z00m128/speccy2010/documentation/speccy2010_r1_bottom.jpg

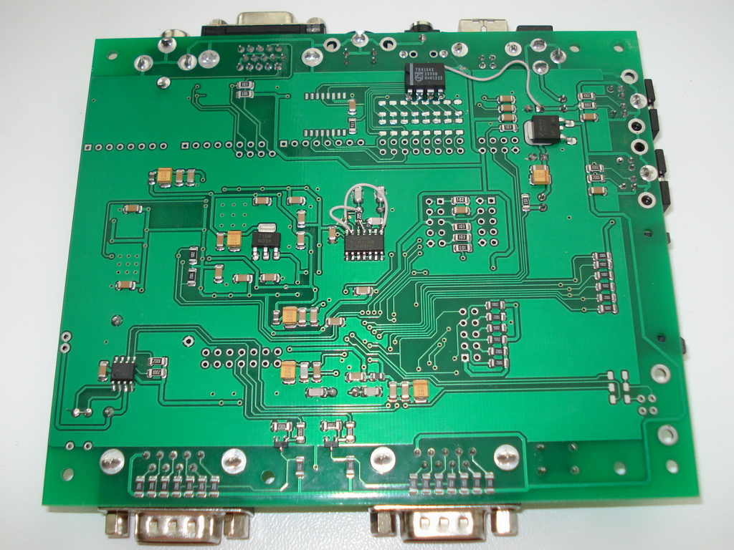
documentation/speccy2010_r1_bottom.jpg
