z00m128/speccy2010/documentation/speccy2010_r1_top.jpg

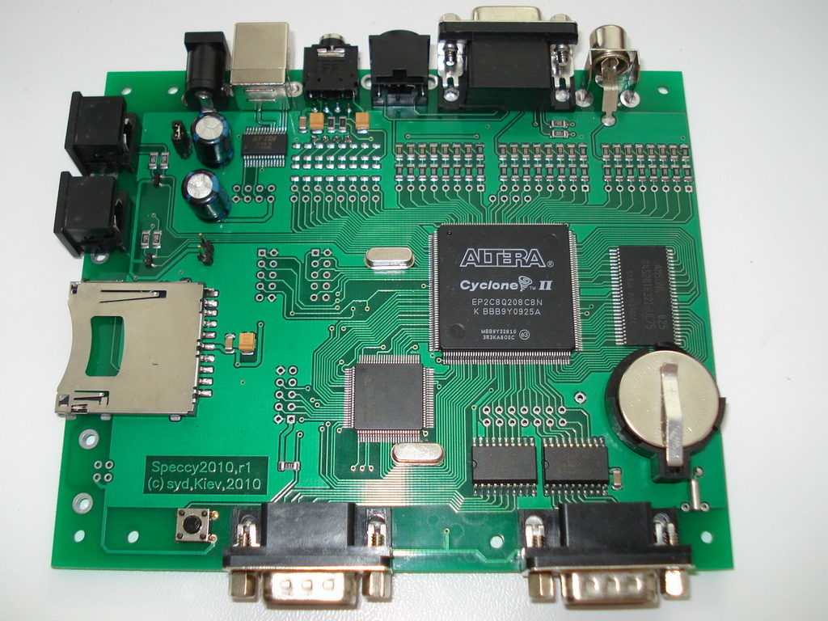
documentation/speccy2010_r1_top.jpg
