z00m128/speccy2010/documentation/Speccy2010-sticker.pdf

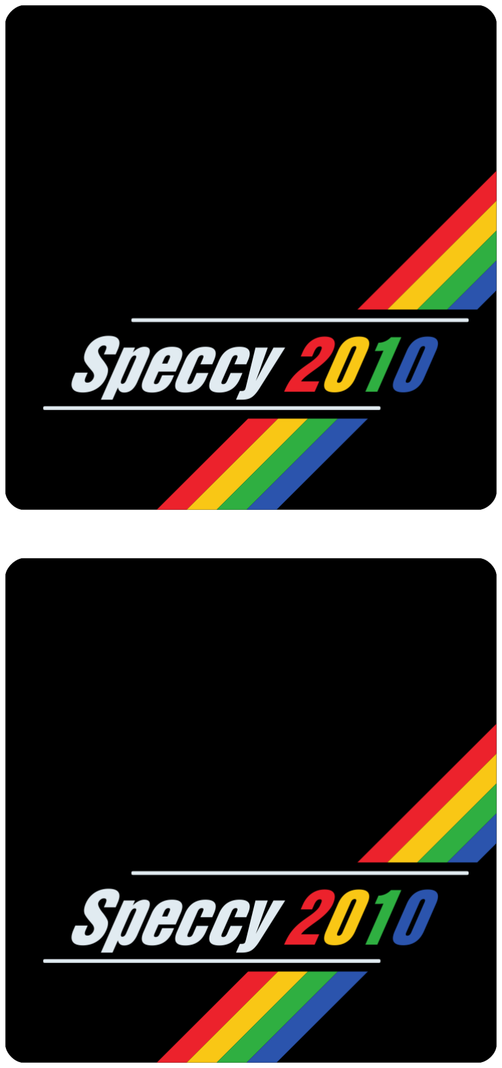
[picture p3: page 1]
