z00m128/speccy2010/documentation/codeblocks.png

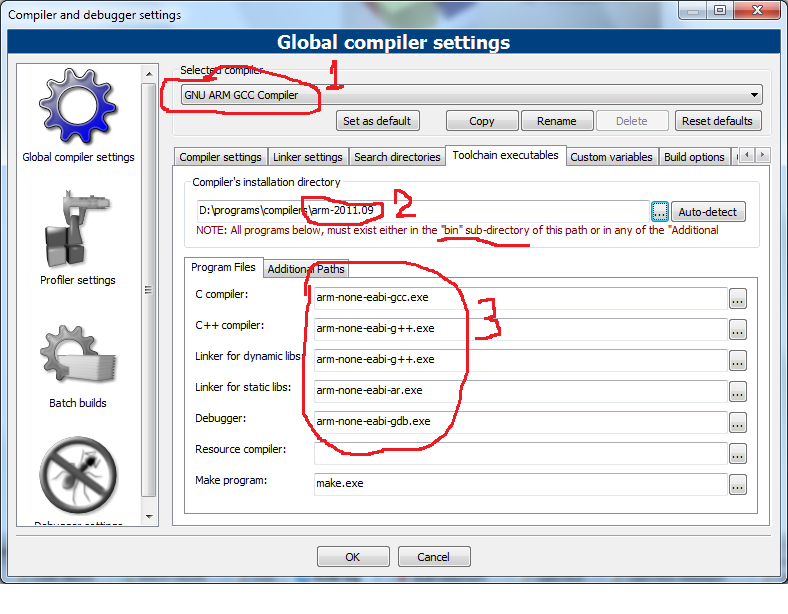
documentation/codeblocks.png
