z00m128/speccy2010/documentation/Speccy2010-sticker.png

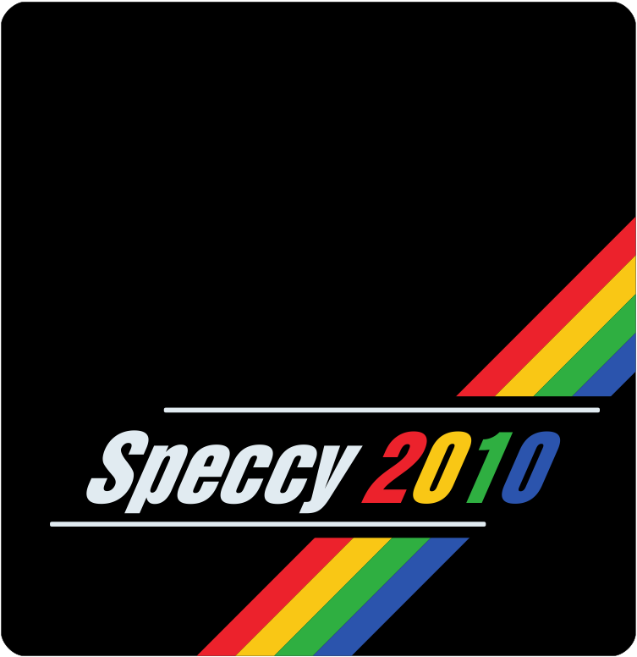
documentation/Speccy2010-sticker.png
