z00m128/speccy2010/documentation/Speccy2010_r2.bom.pdf

Перечень комплектующих

Резистор | R1206 0.25W, 100 1% | 21 | R42, R44, R46, R48, R50, R52, R54, R56, R58, R60, R62, R64, R66, R68, R70, R72, R74, R76, R80, R82, R84
Резистор | R1206 0.25W, 150 | 6 | R3, R6, R16, R17, R90, R95
Резистор | R1206 0.25W, 200 1% | 27 | R38, R39, R40, R41, R43, R45, R47, R49, R51, R53, R55, R57, R59, R61, R63, R65, R67, R69, R71, R73, R75, R79, R81, R83, R85, R86, R87
Резистор | R1206 0.25W, 750 1% | 2 | R104, R110
Резистор | R1206 0.25W, 887 1% | 1 | R109
Резистор | R1206 0.25W, 1k | 1 | R130
Резистор | R1206 0.25W, 2k | 10 | R1, R2, R14, R15, R22, R26, R29, R33, R141, R142
Резистор | R1206 0.25W, 10k | 36 | R8, R9, R10, R11, R12, R13, R18, R19, R21, R23, R24, R25, R27, R30, R31, R32, R34, R35, R36, R37, R77, R78, R125, R126, R127, R128, R129, R131, R132, R133, R134, R135, R136, R137, R138, R139
Резистор | R1206 0.25W, 2M | 1 | R140
Конденсатор | C1206-X7R-50V, 22p | 2 | C23, C24
Конденсатор | C1206-X7R-50V, 33p | 2 | C36, C40
Конденсатор | C1206-X7R-50V, 47p | 1 | C39
Конденсатор | C1206-X7R-50V, 1n | 3 | C43, C46, C49
Конденсатор | C1206-X7R-50V, 33n | 1 | C26
Конденсатор | C1206-X7R-50V, 100n | 27 | C1, C2, C4, C5, C6, C9, C10, C11, C12, C13, C14, C15, C16, C17, C18, C19, C21, C28, C29, C30, C31, C32, C33, C42, C45, C48, C50
Конденсатор | C1206-X7R-50V, 1u | 1 | C27
Конденсатор | EHR-220.0X25V, 220.0-25V | 2 | C34, C35
Конденсатор | TAJB106M016R, 10.0-16V | 9 | C3, C7, C8, C25, C37, C38, C41, C44, C47
Катушка индуктивности | BLM21AG601SN1 | 3 | L1, L2, L3
Кварц | HC3X8, 32.768 | 1 | BQ3
Кварц | HC49U, 20MHz | 1 | BQ2
Кварц | HC49U, 4MHz | 1 | BQ1
Диод | BAT54C | 2 | VD1, VD2
Транзистор | BC817-40 | 2 | VT1, VT2
Микросхема | LM1117DX-3.3 | 1 | DA1
Микросхема | LM1117MP-ADJ | 1 | DA2
Микросхема | 74HCU04D | 1 | DD8
Микросхема | 74LVC245D | 2 | DD2, DD3
Микросхема | DS1338Z-33+ | 1 | DD9
Микросхема | EP2C8Q208-C8 | 1 | DD5
Микросхема | FT232RL | 1 | DD1
Микросхема | K4S281632-TC75 (K4S561632-TC75) | 1 | DD7
Микросхема | STR755FV2 (STR750FV2) | 1 | DD6
Микросхема | TDA1543 | 1 | DD4`
Разъем | BH1060 | 1 | GB1`
Разъем | DRB-9M | 2 | XP2, XP3
Разъем | PLS-2 | 2 | XP7, XP10
Разъем | DD15RF | 1 | XS9
Разъем | JC-128 | 1 | XS6

Перечень комплектующих

Разъем | MINI-DIN4+3 | 1 | XS8
Разъем | MINI-DIN6+3 | 2 | XS2, XS5
Разъем | POWER | 1 | XS10
Разъем | RCA | 1 | XS7
Разъем | SDC09W4 (104C-TAA0-R) | 1 | XS4
Разъем | USBB-4G | 1 | XS1
Клавиша | KEY | 1 | SB1
Плата печатная | Speccy2010_r2 | 1
Корпус | Z28 | 1
Монтаж | | 1
| | 189
