z00m128/speccy2010/documentation/speccy2010_r2.pcb.pdf

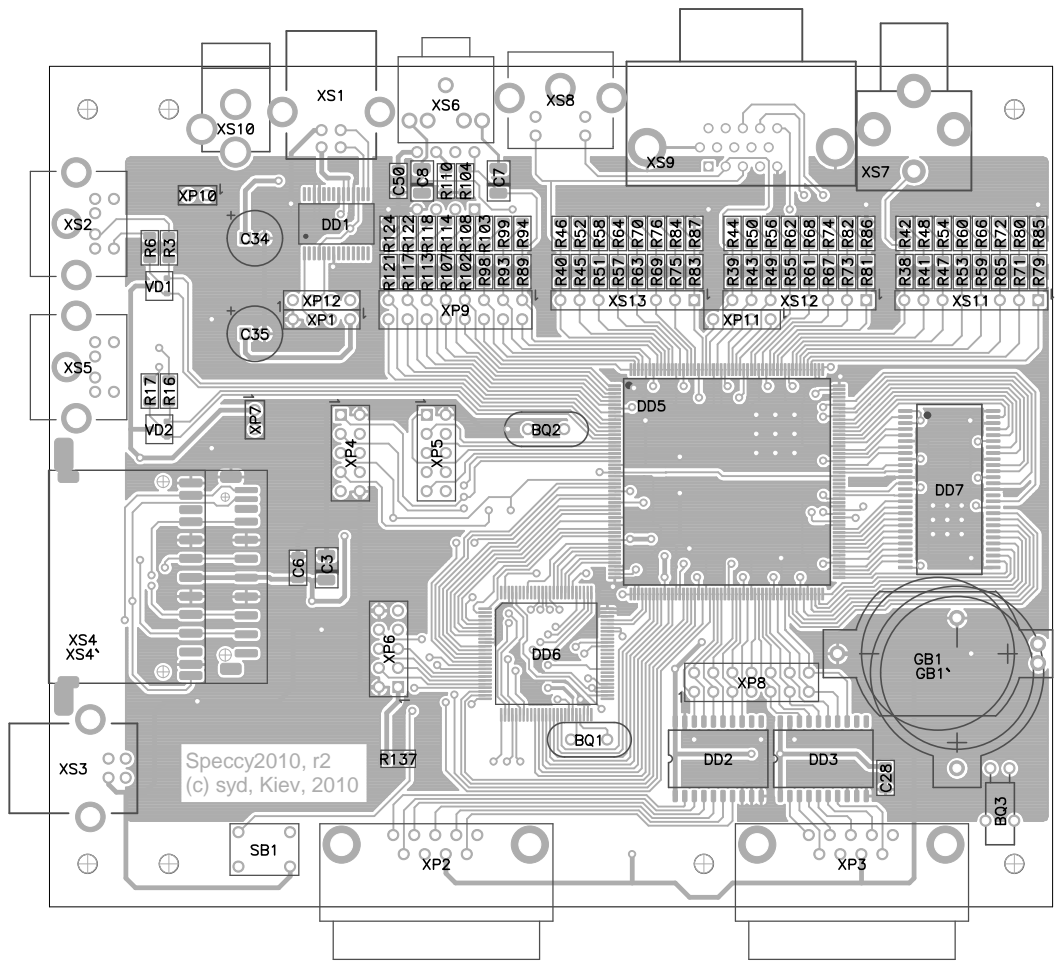
[picture p15: page 1]
Speccy2010, r2 (c) syd, Kiev, 2010

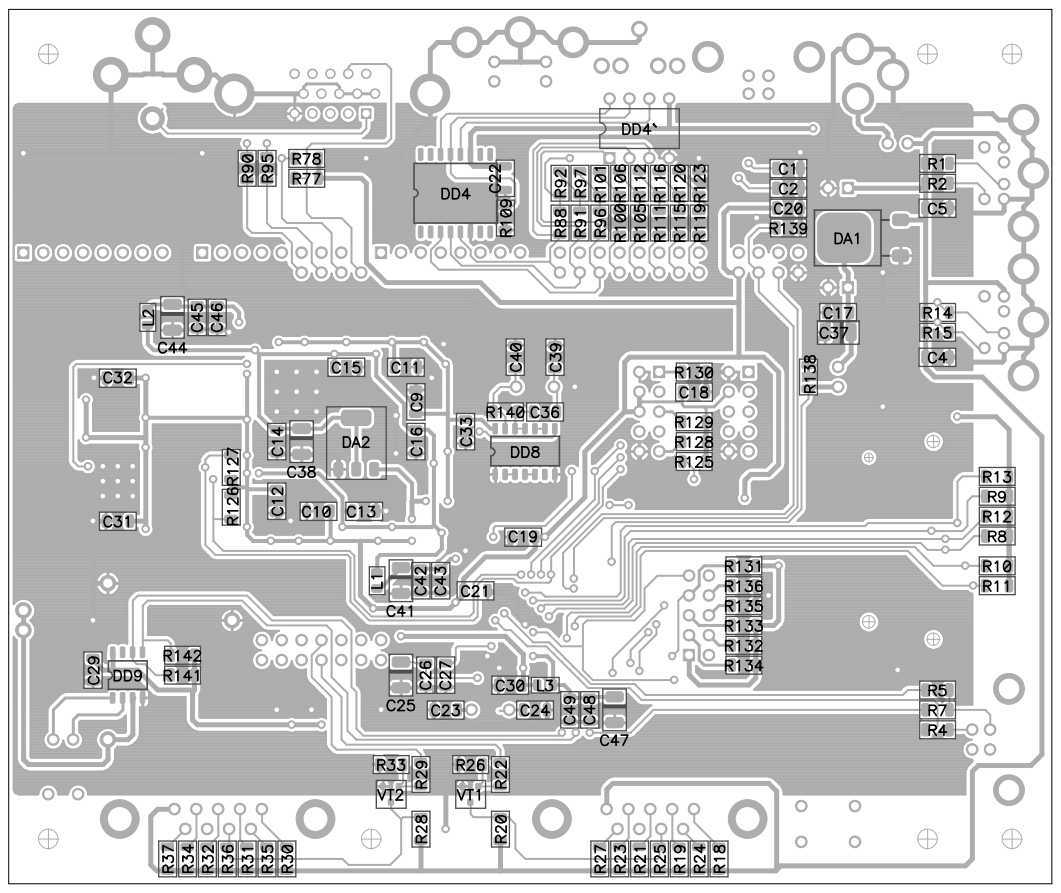
[picture p16: page 2]
