z00m128/speccy2010/documentation/speccy2010_r2.sch.pdf

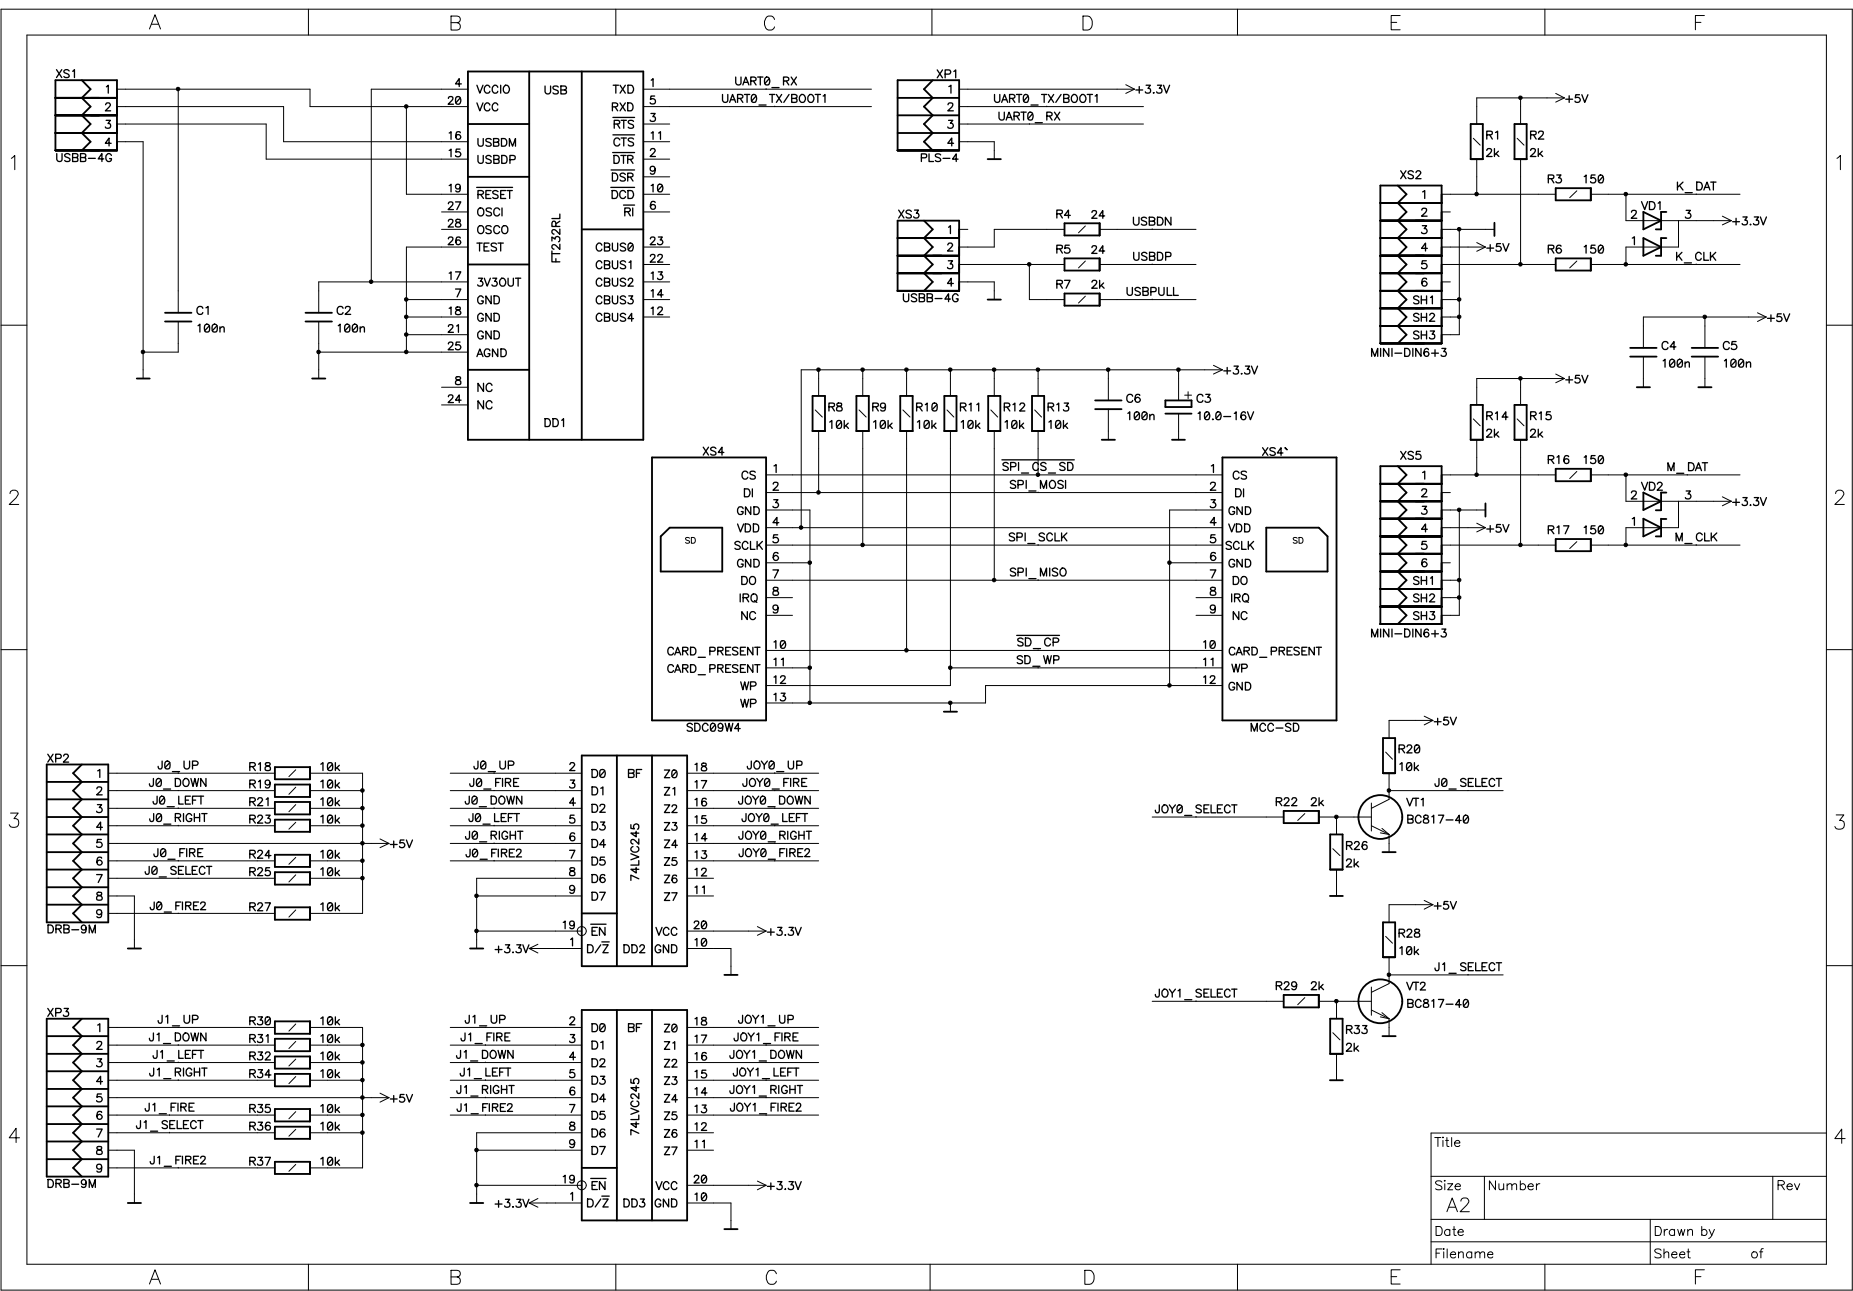
[picture p17: page 1]

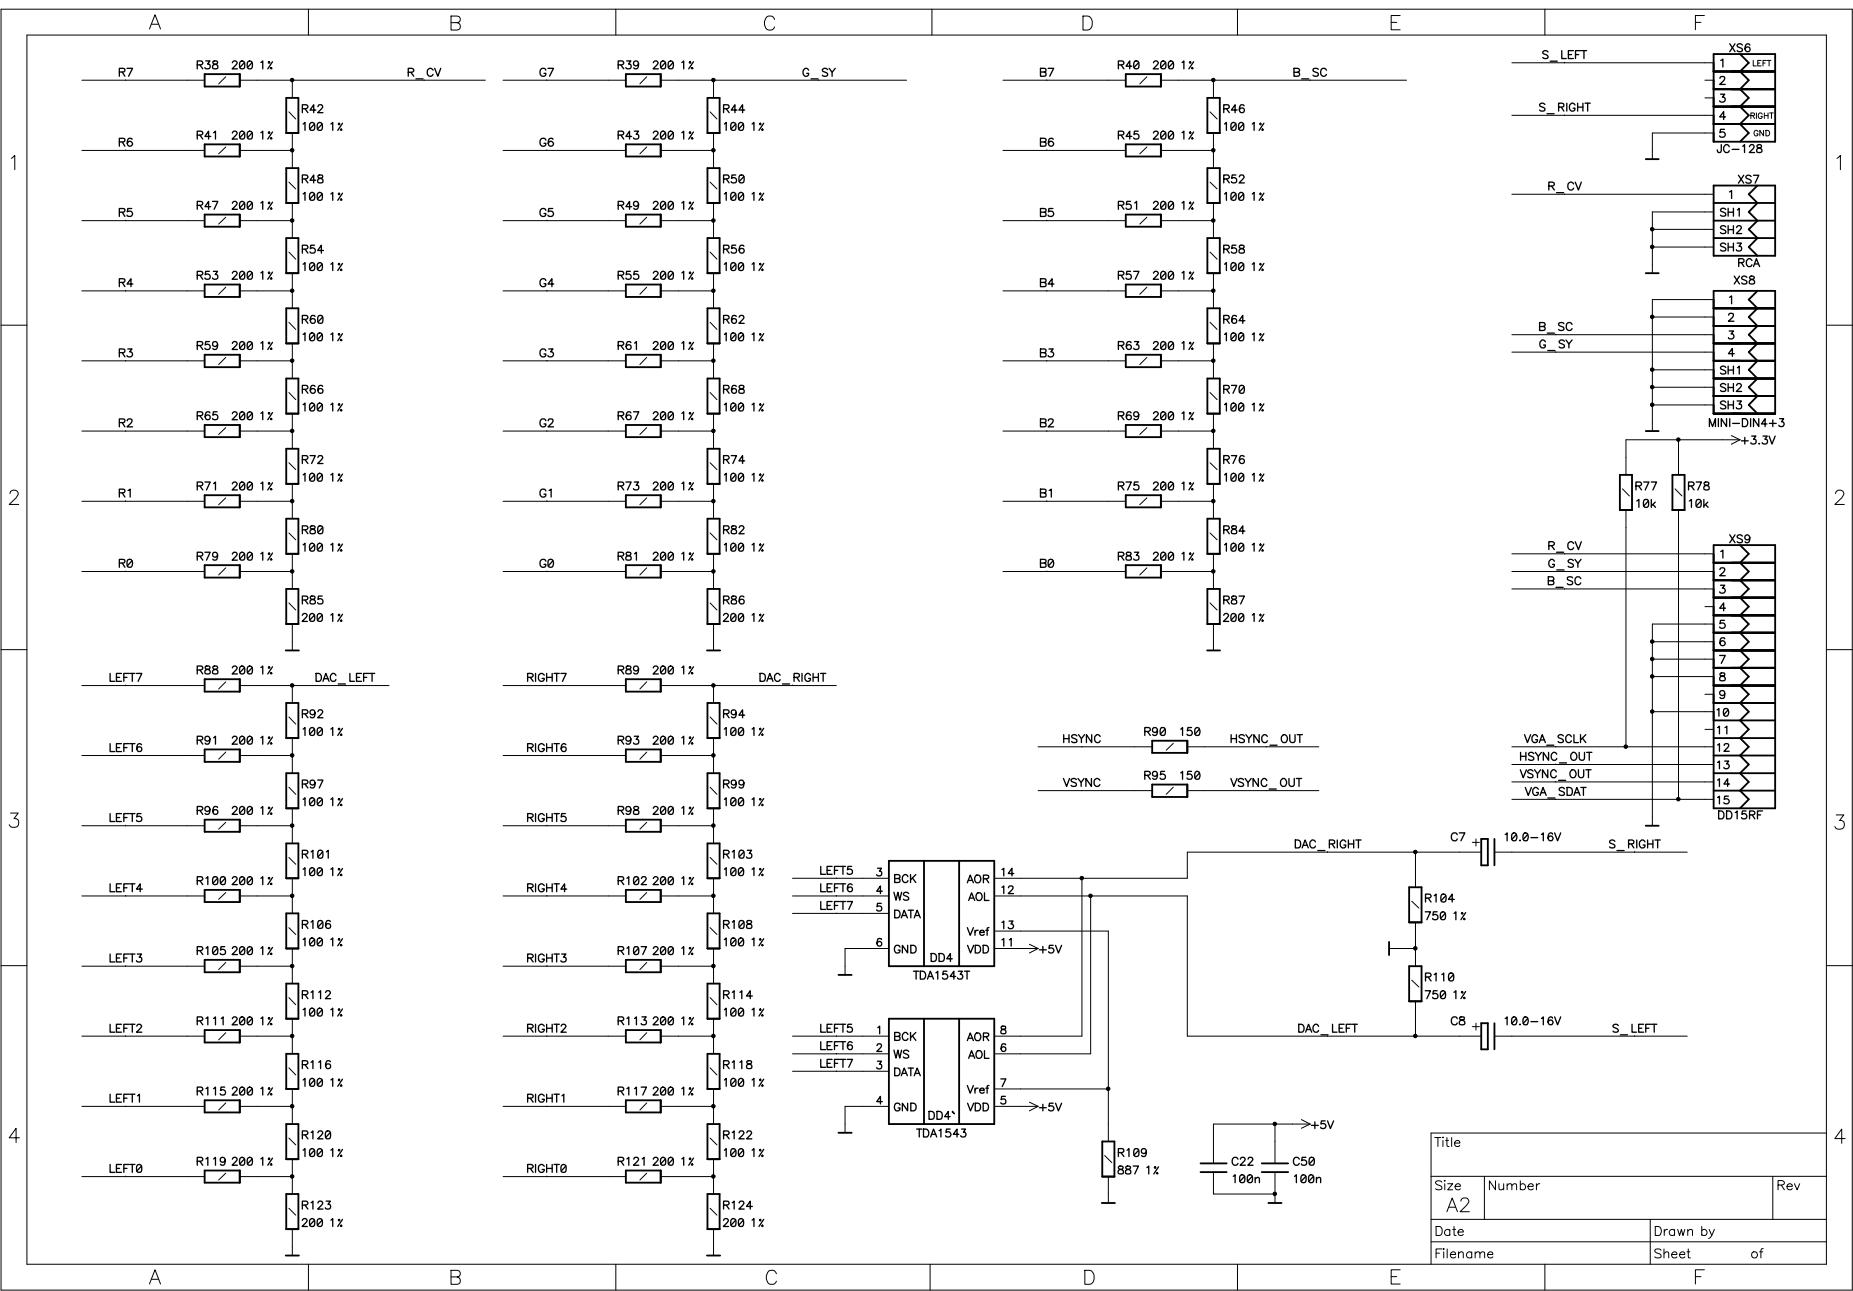
[picture p18: page 2]

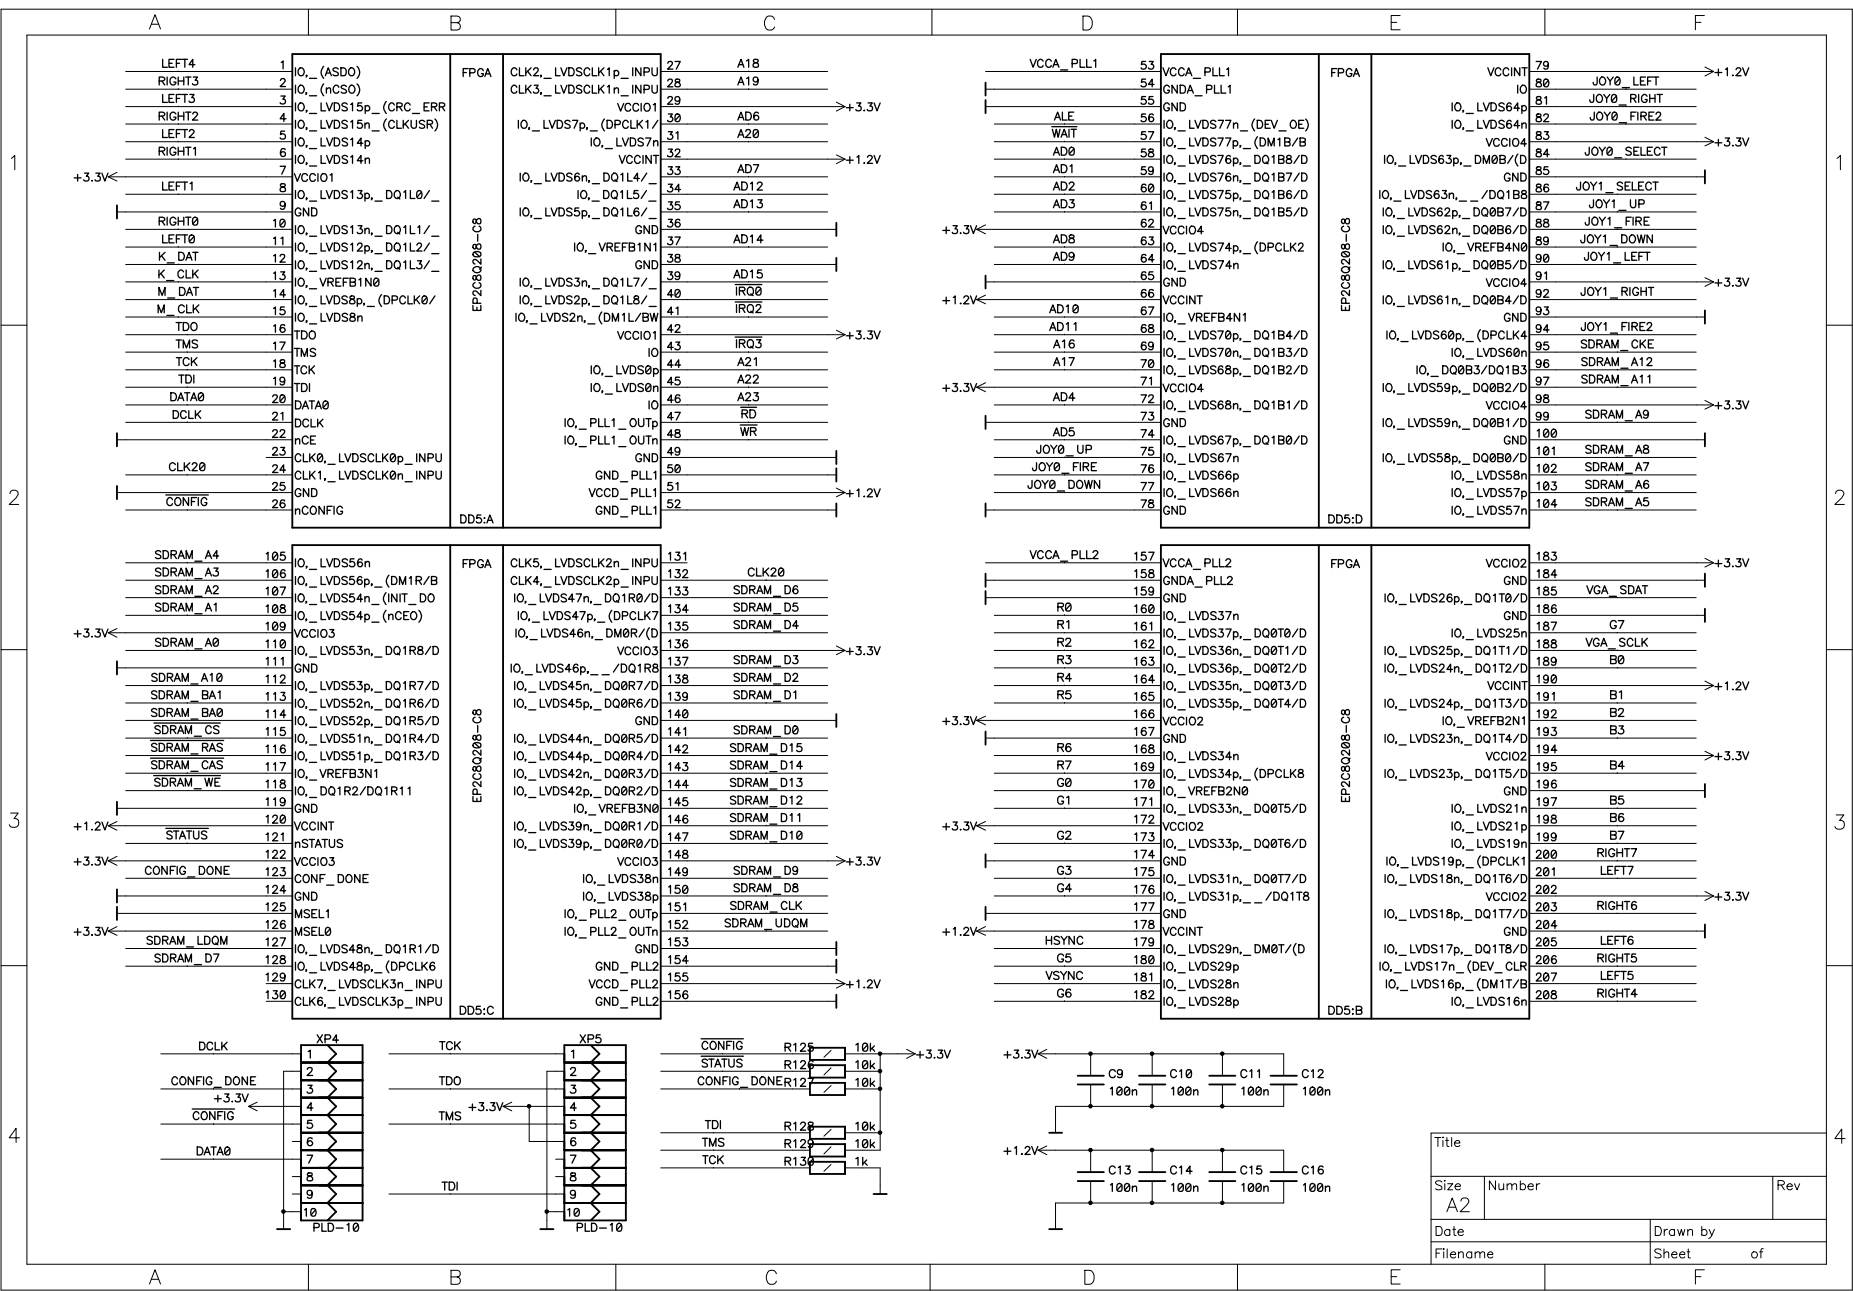
[picture p19: page 3]

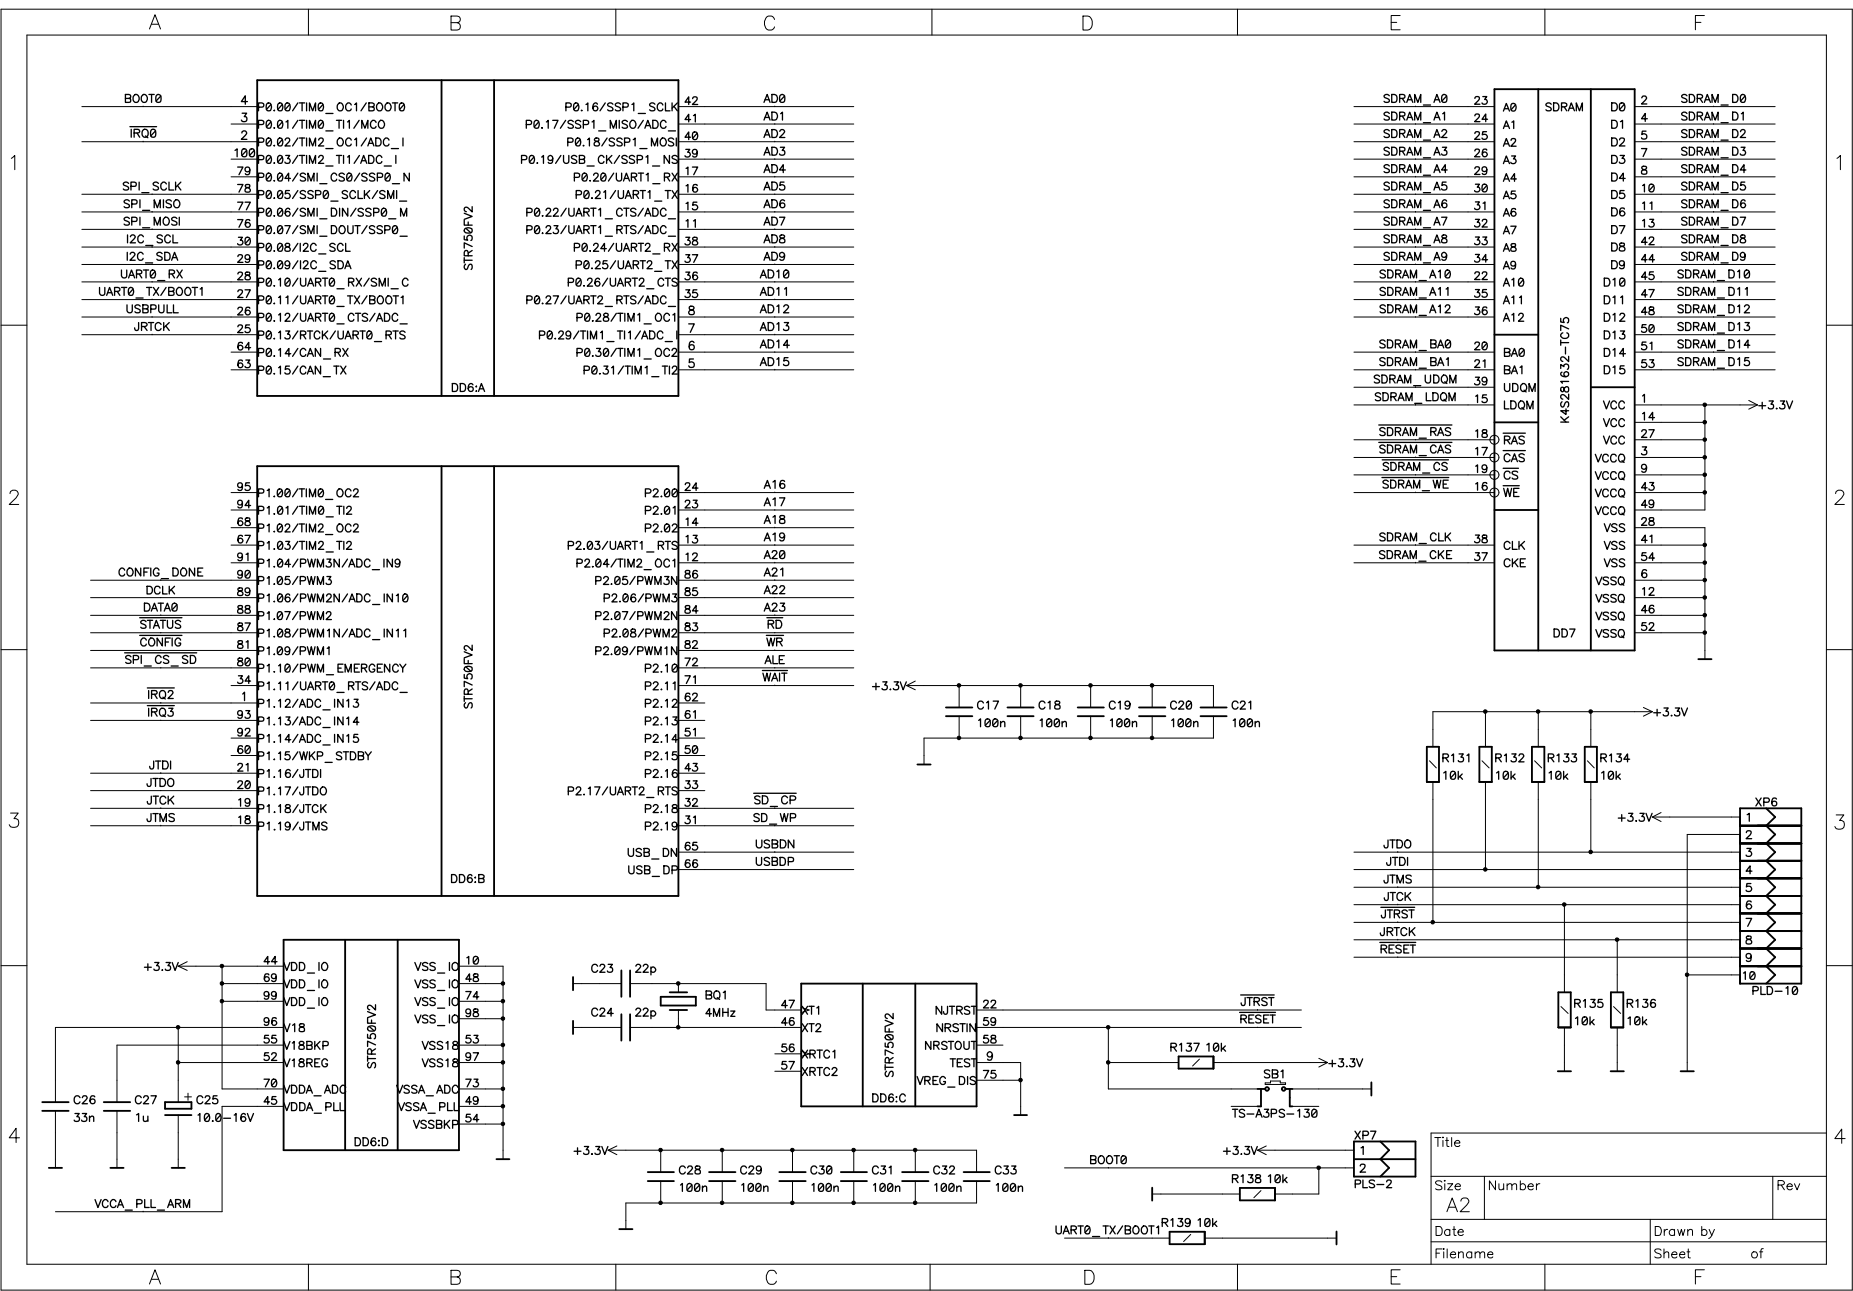
[picture p20: page 4]

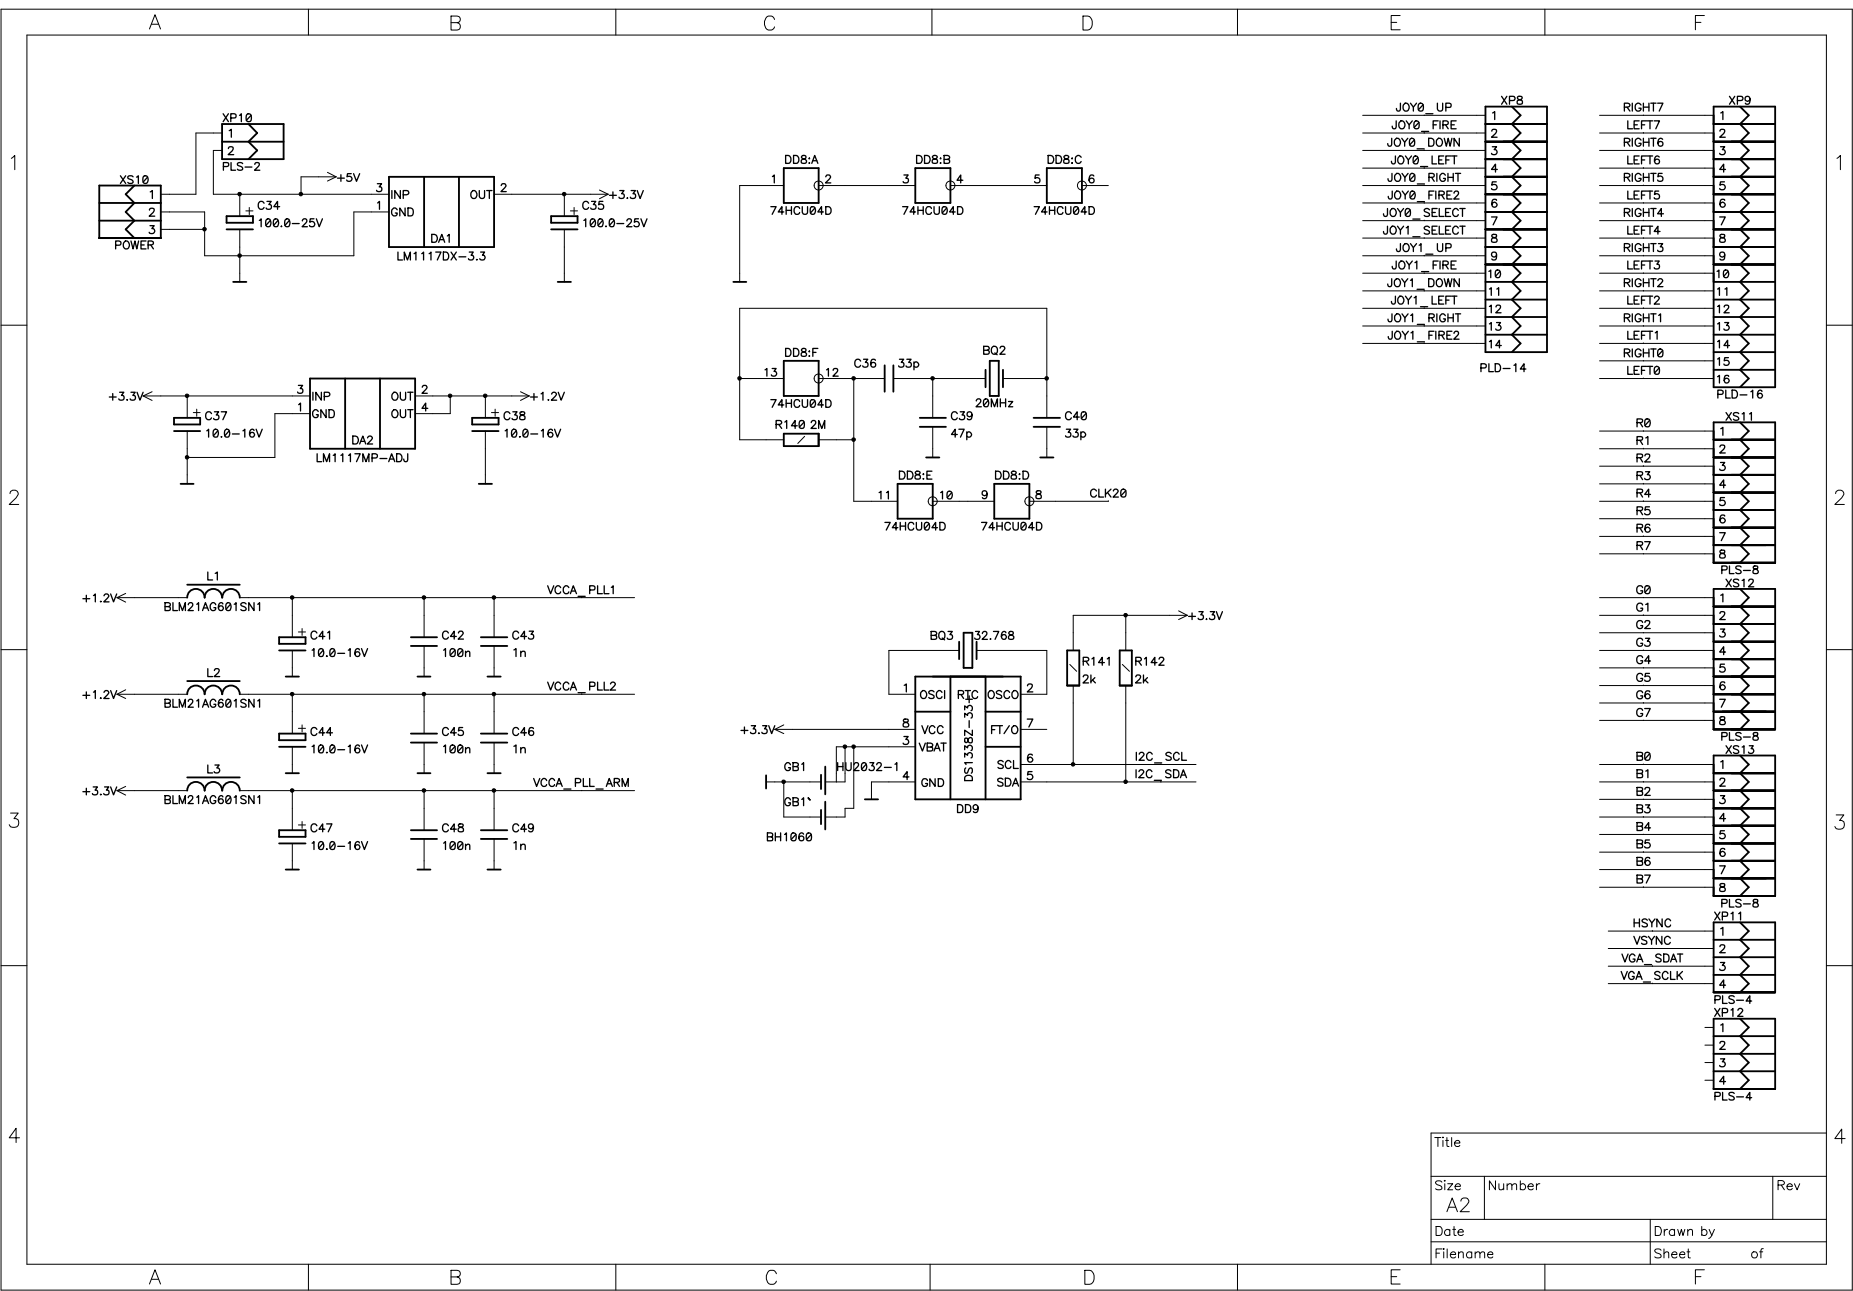
[picture p21: page 5]
