z00m128/speccy2010/documentation/Speccy2010_r1.pcb.pdf

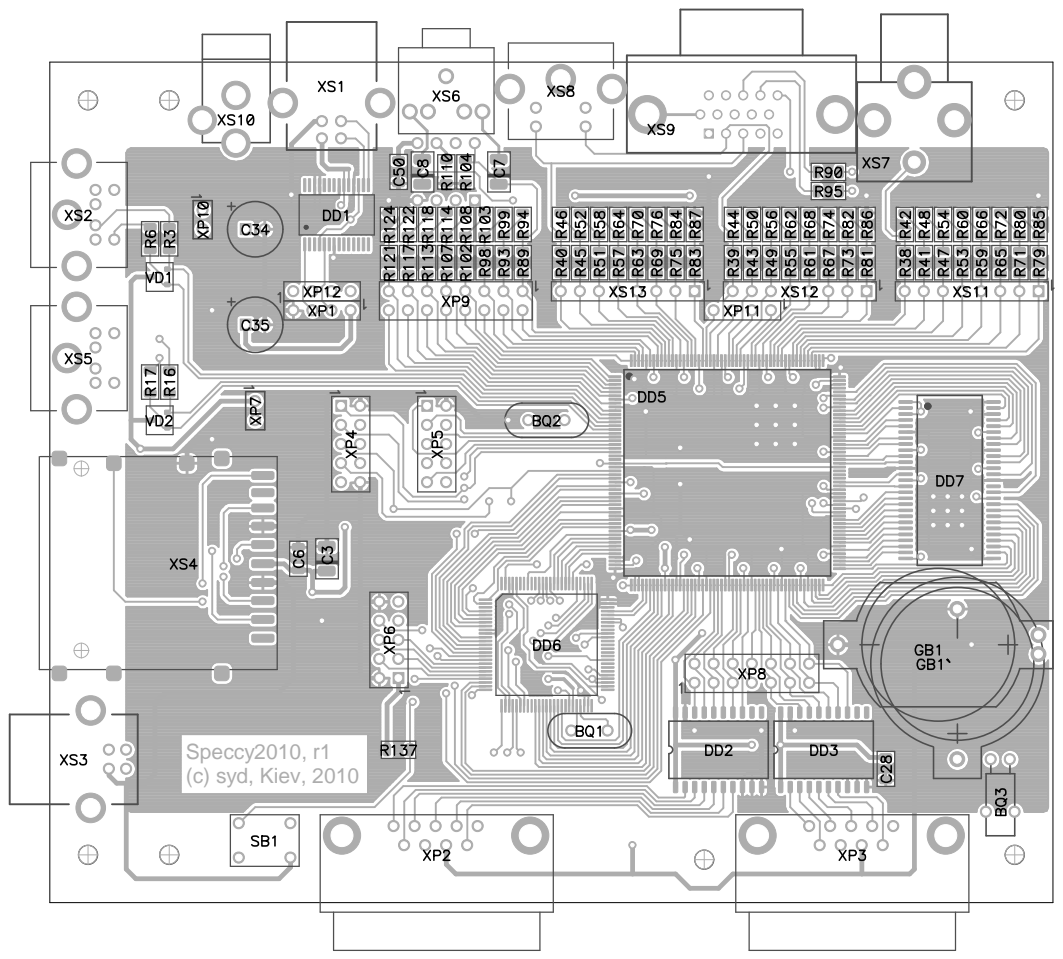
[picture p22: page 1]
Speccy2010, r1 (c) syd, Kiev, 2010

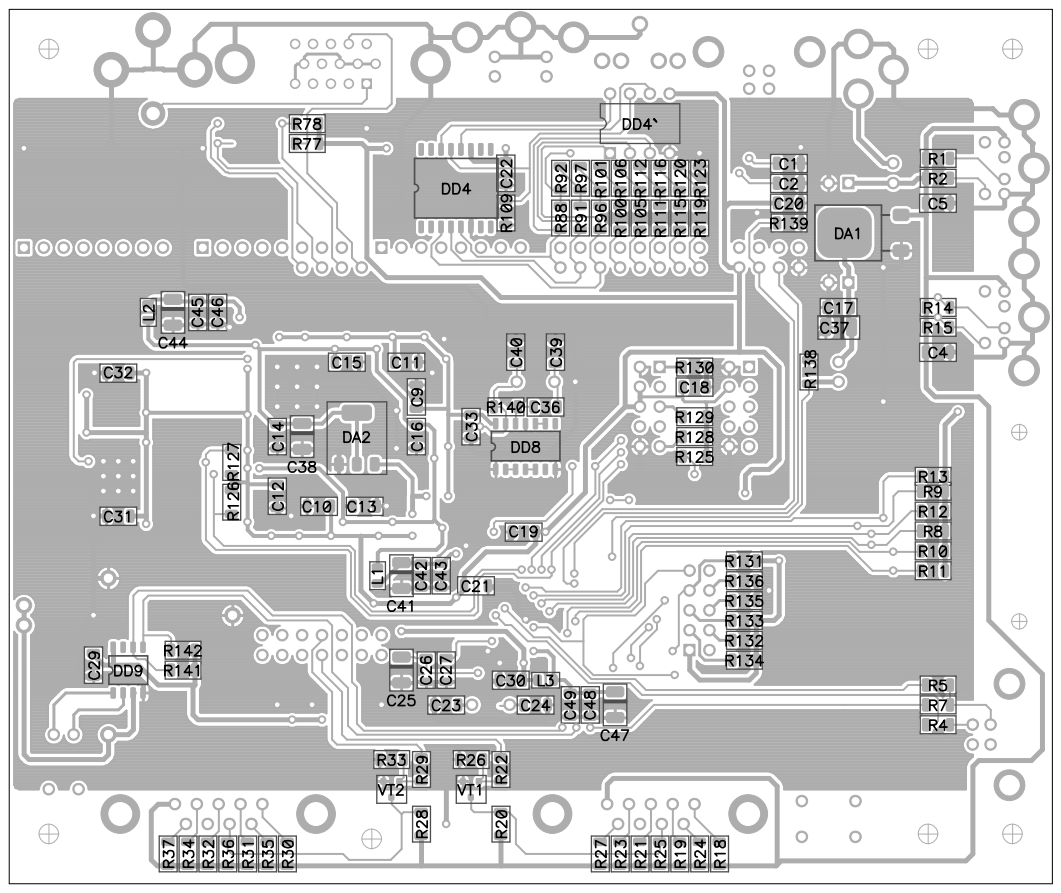
[picture p23: page 2]
