z00m128/speccy2010/documentation/Speccy2010_r1.sch.pdf

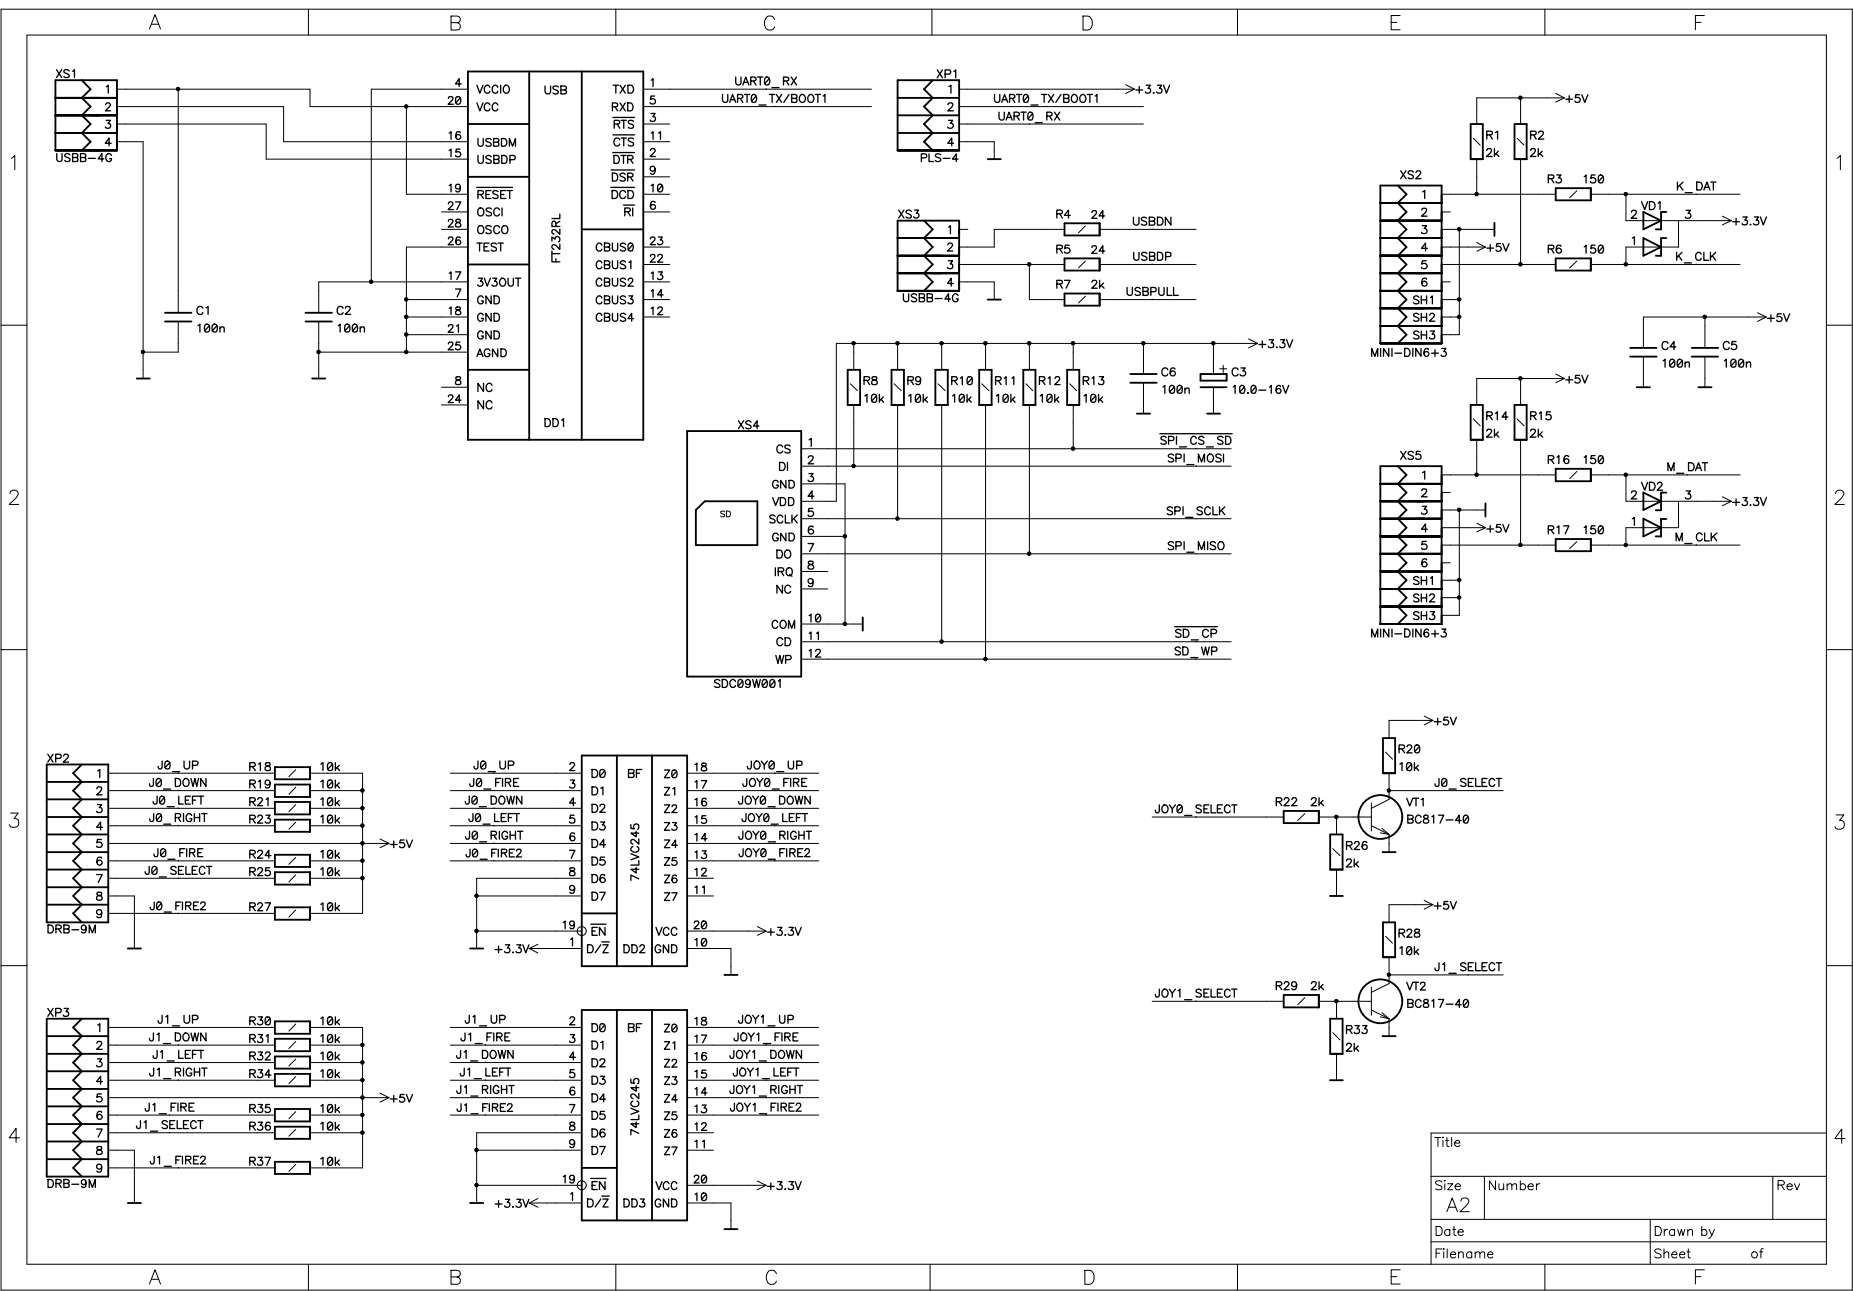
[picture p24: page 1]

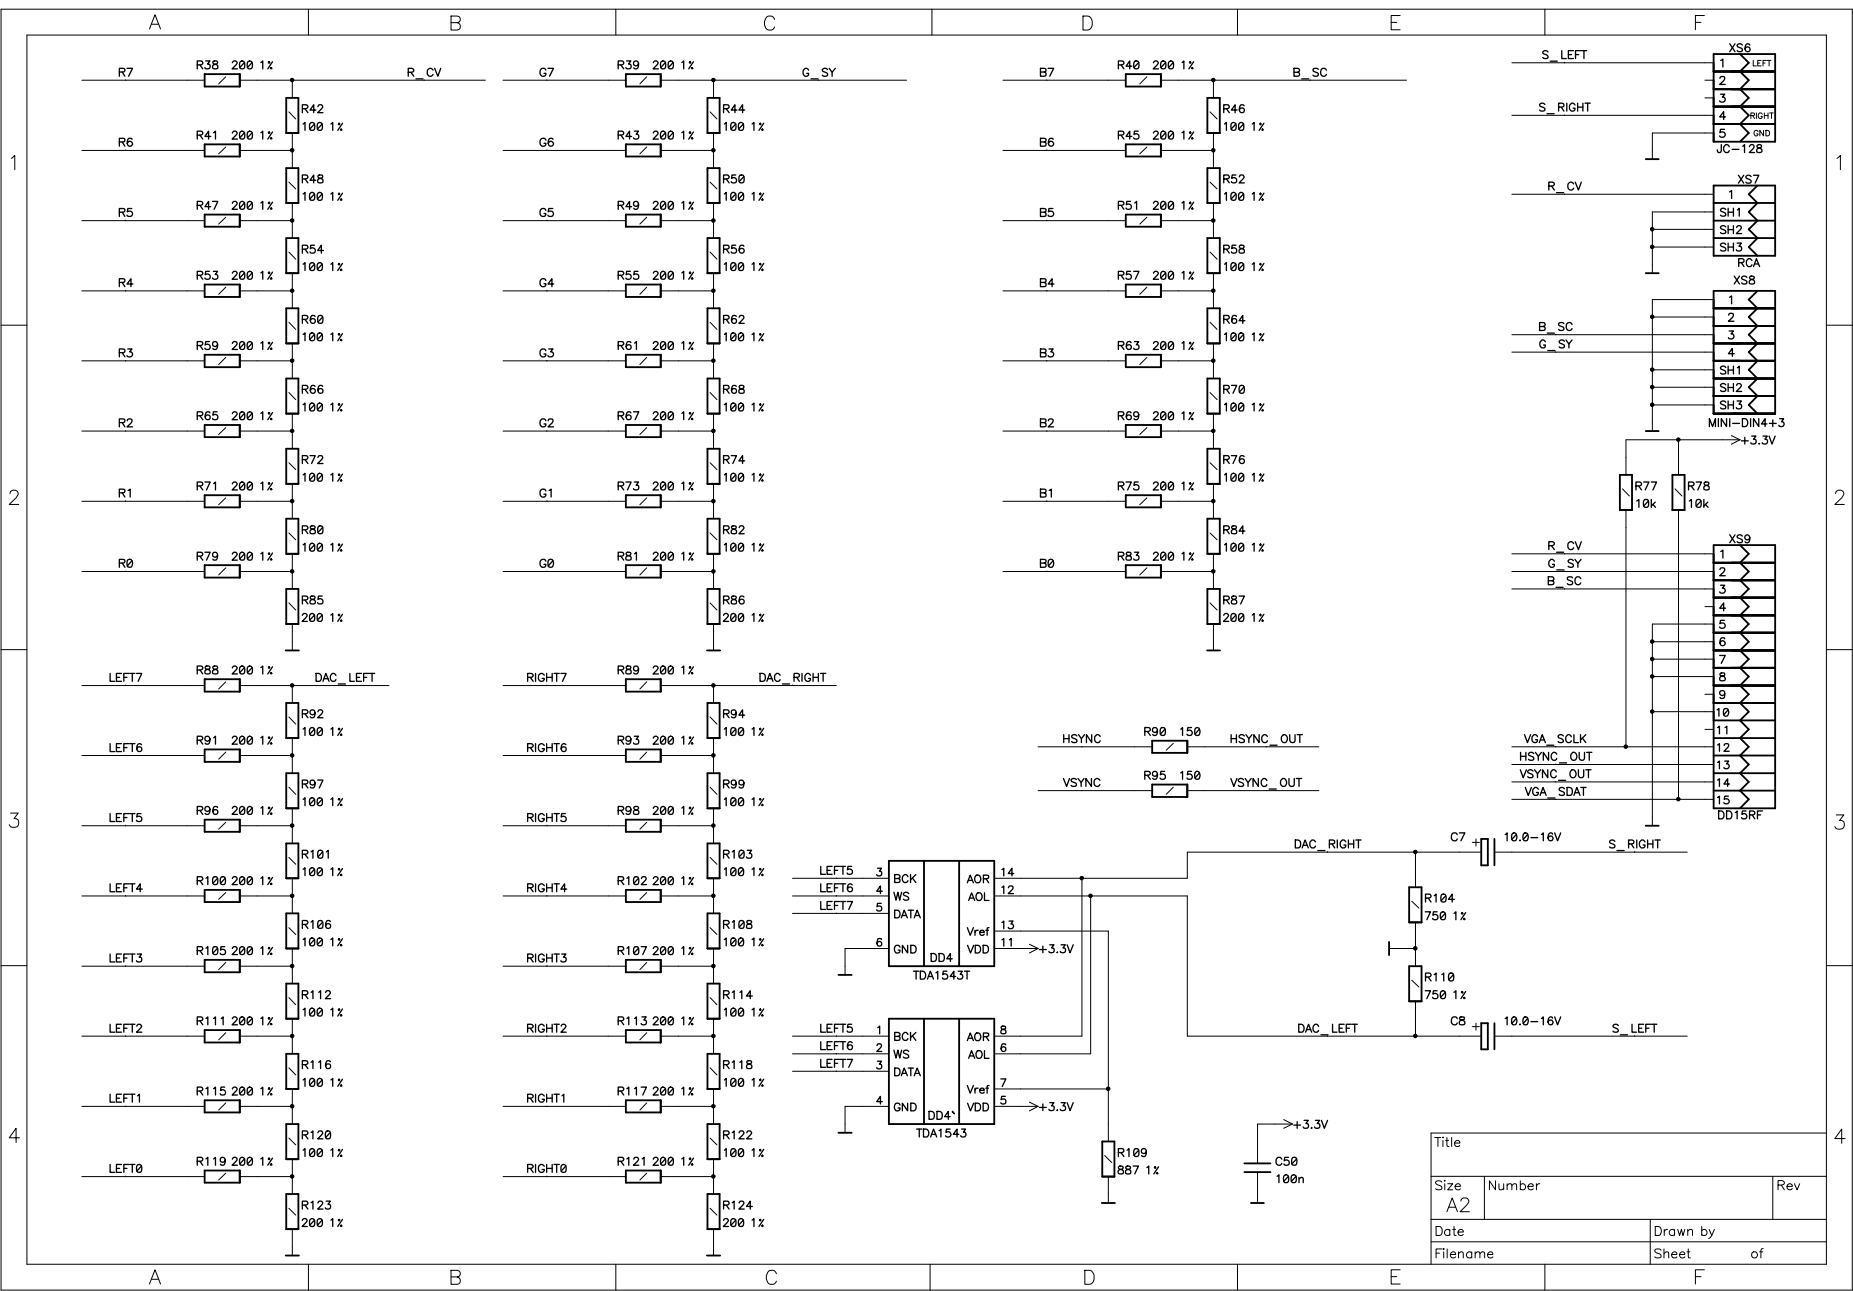
[picture p25: page 2]

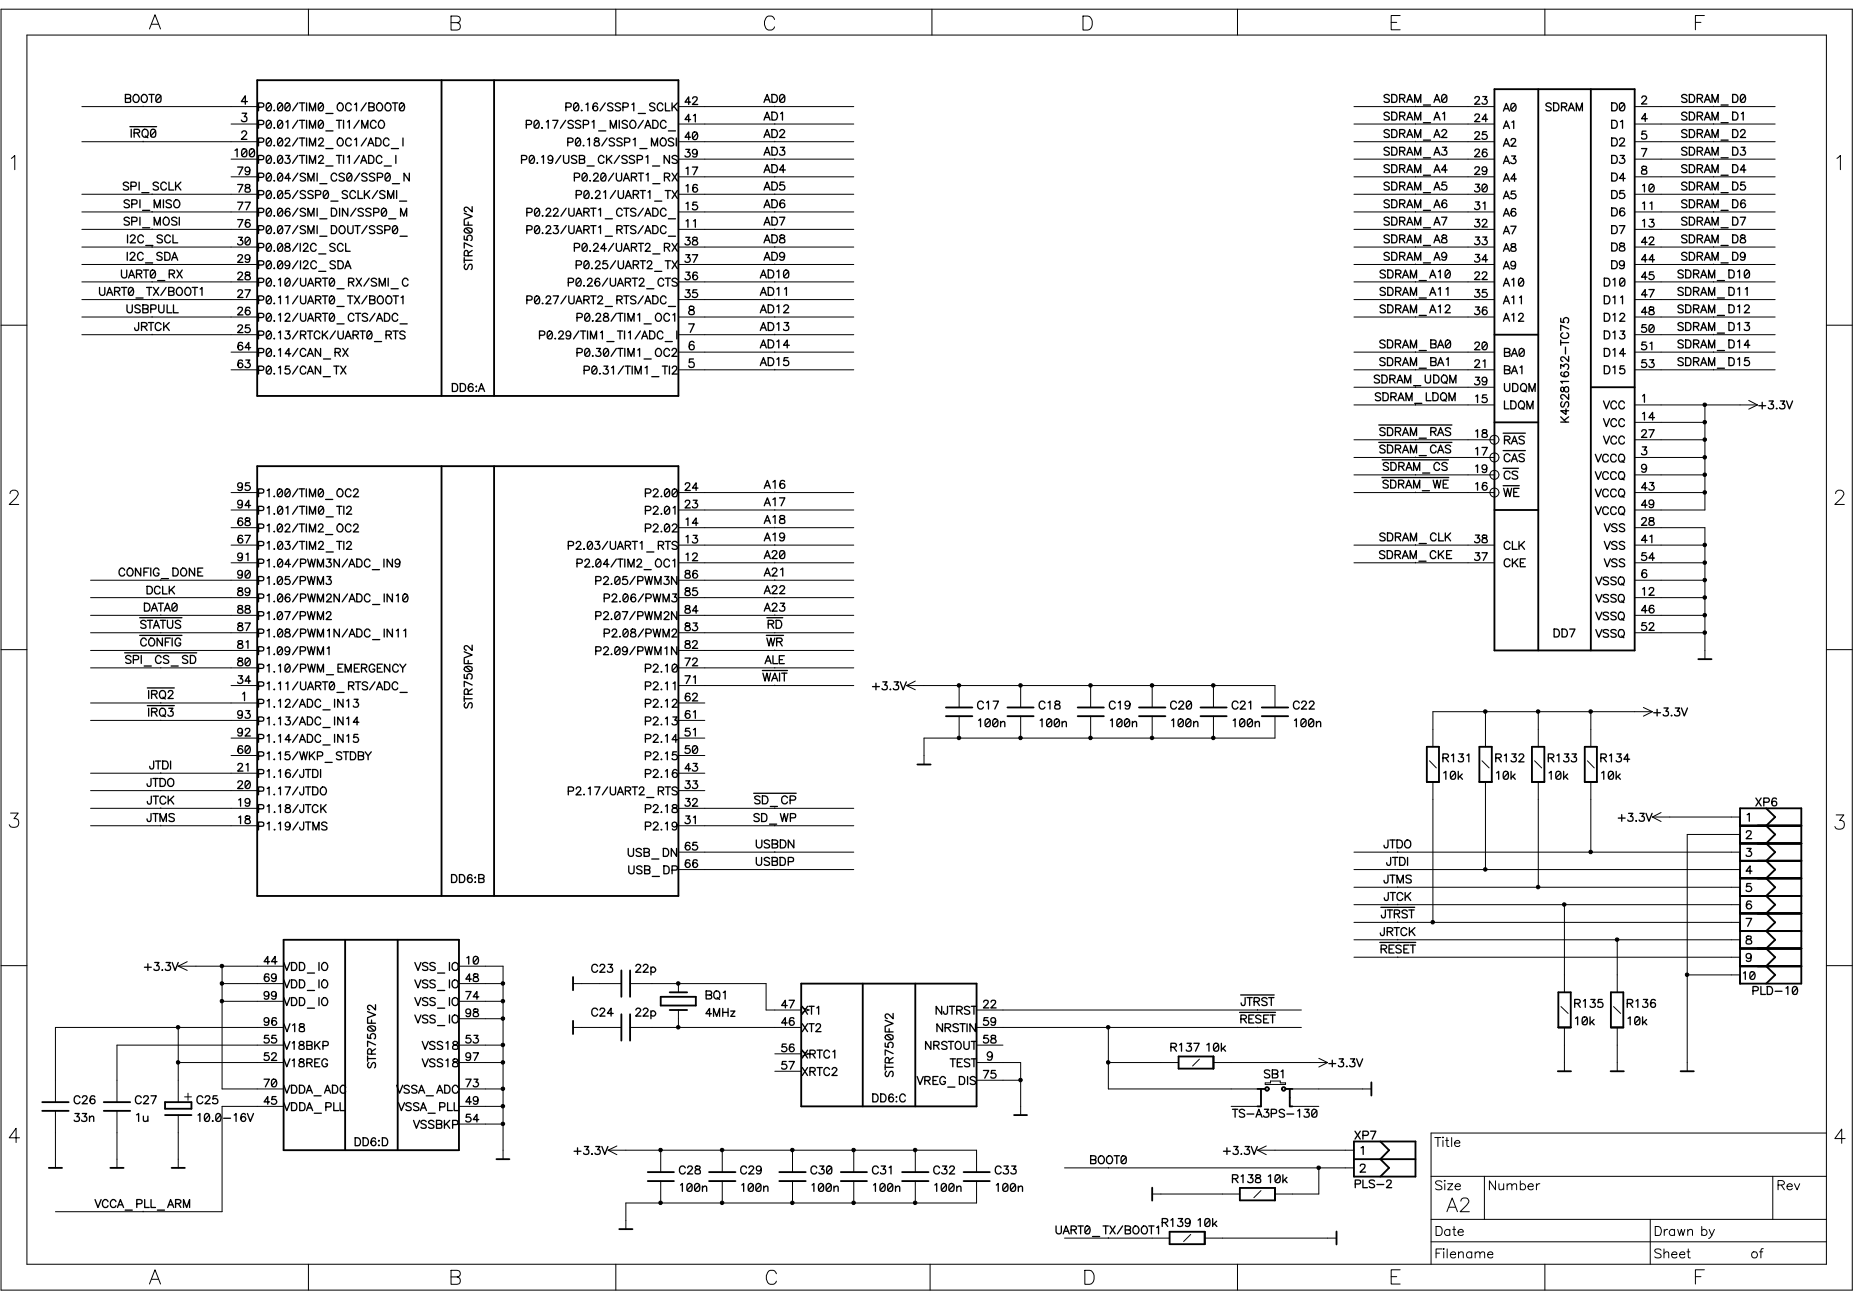
[picture p26: page 3]

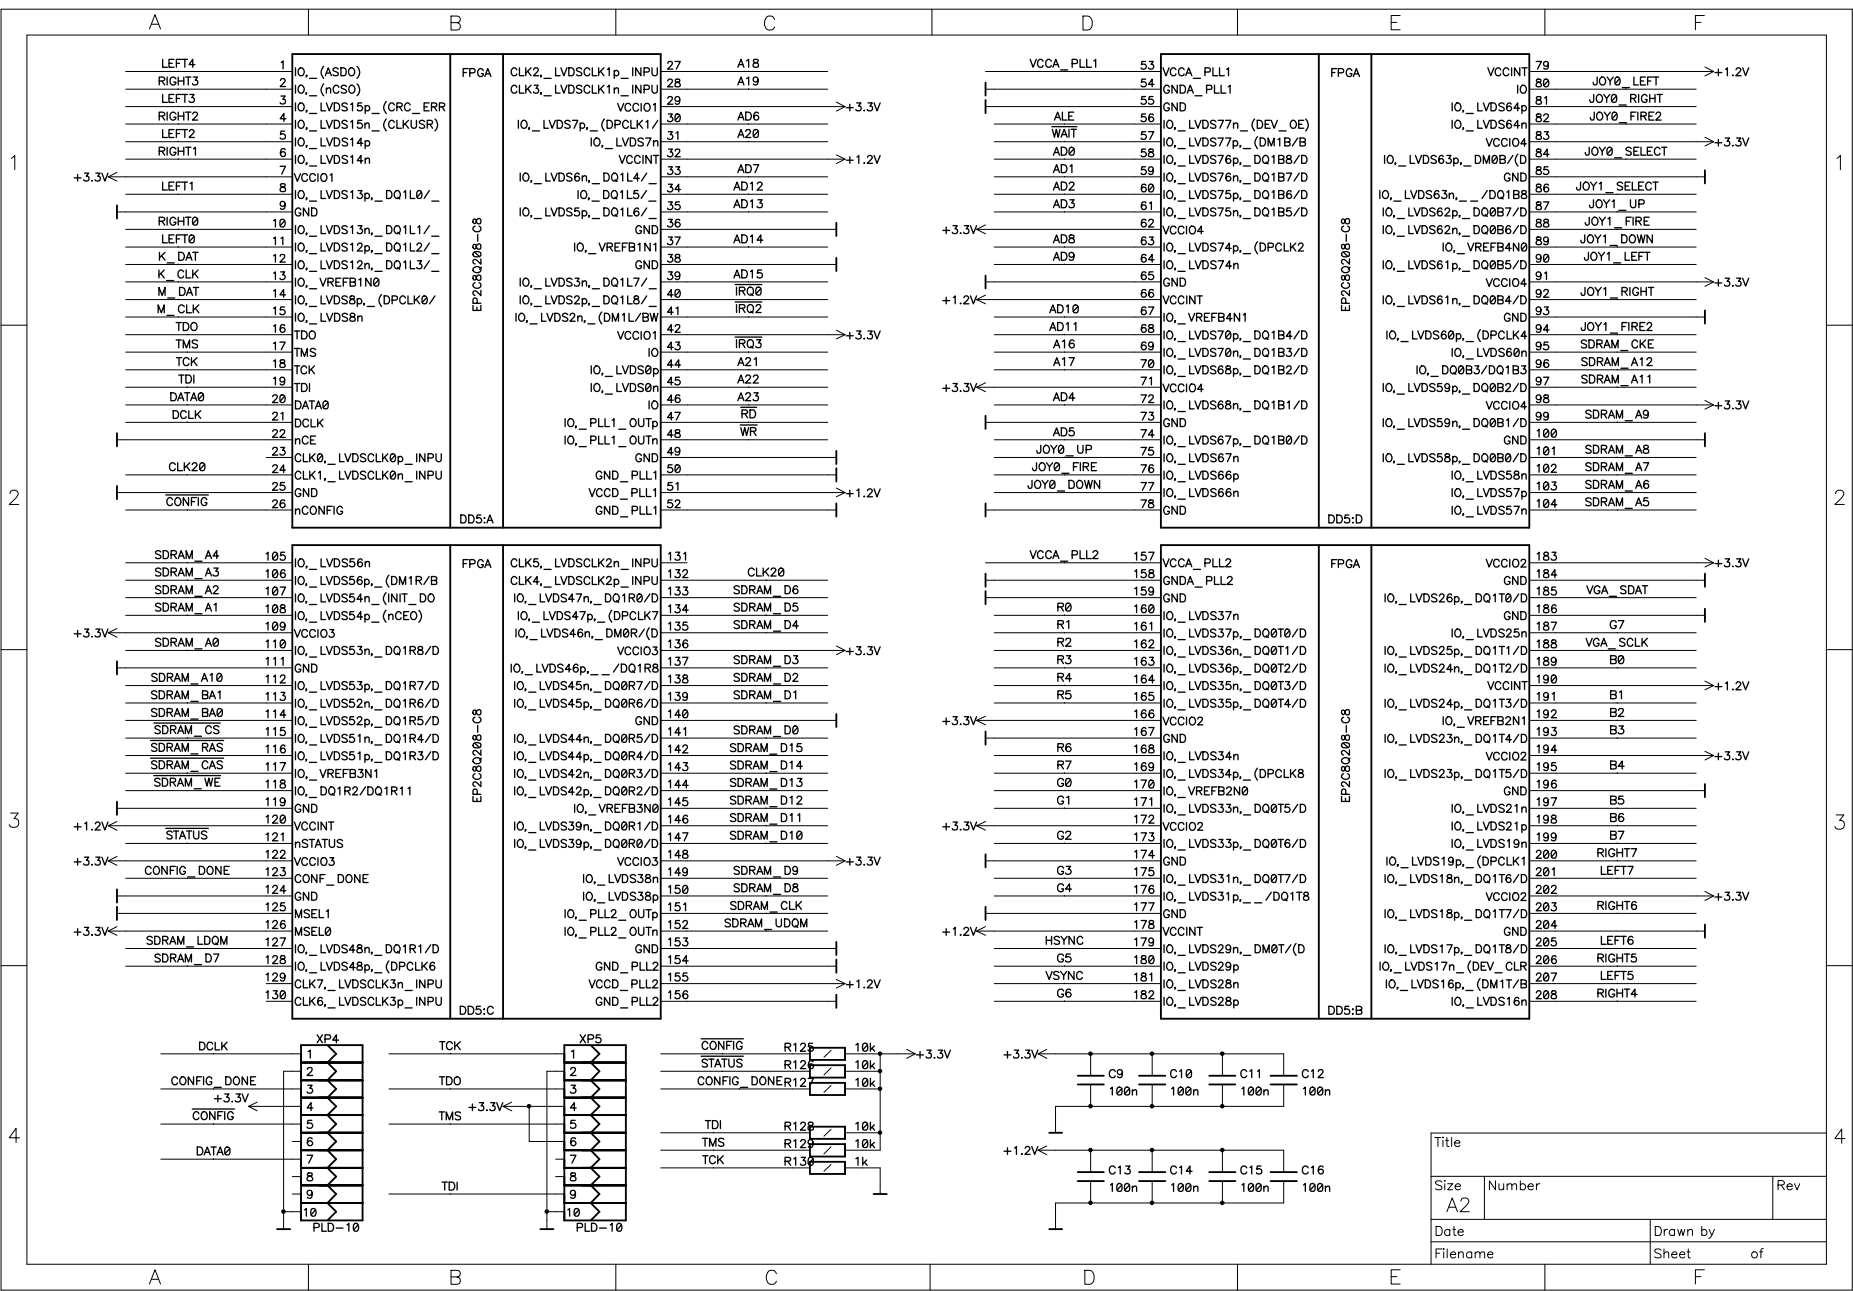
[picture p27: page 4]

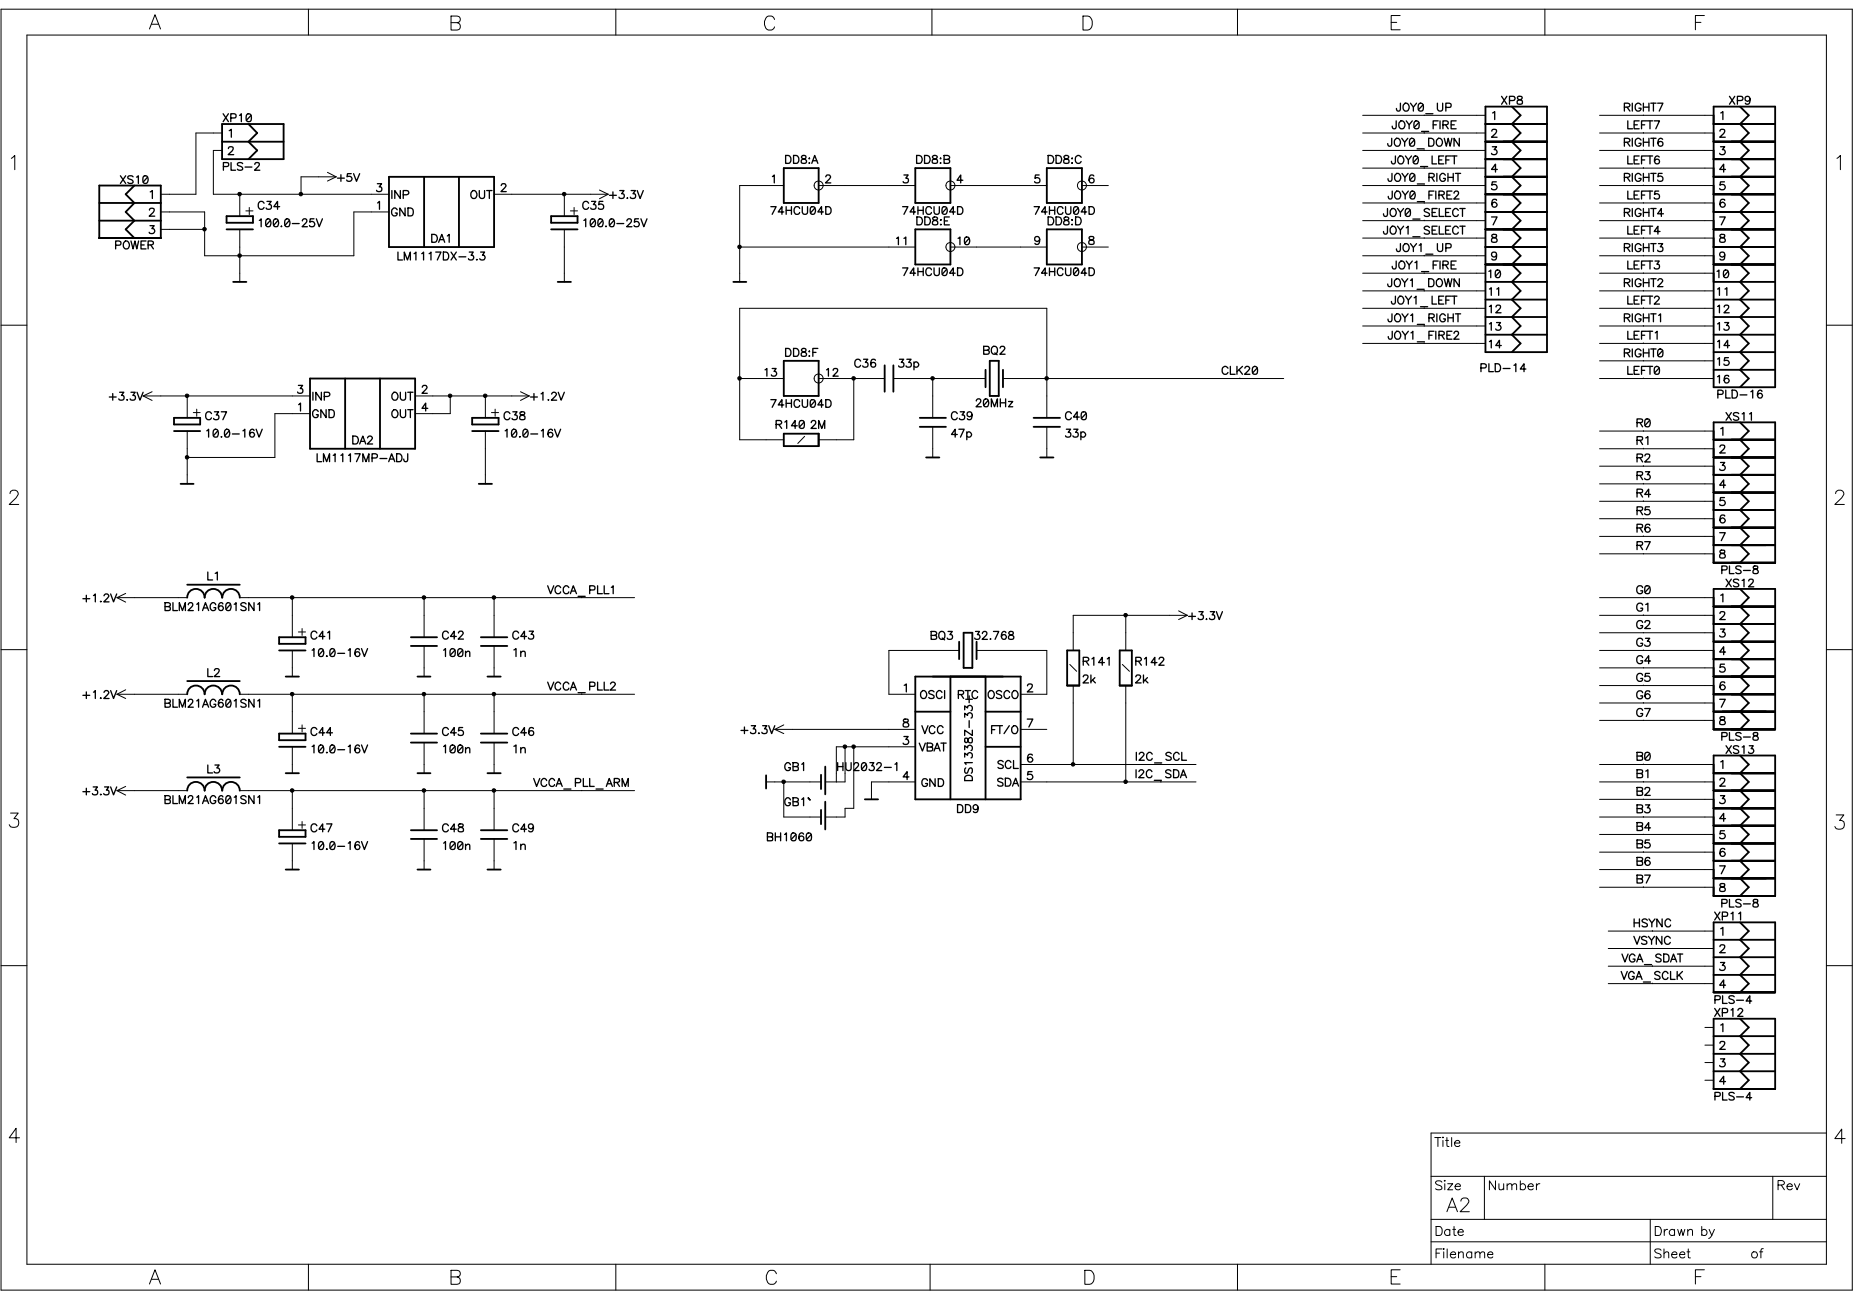
[picture p28: page 5]
