z00m128/speccy2010/(list of files, drawings)

Other design files:
hardware/Speccy2010_r1.pcb
speccy2010/trunk/hardware/Speccy2010_r1.pcb
