z00m128/speccy2010/sources/_experimental/poopi/arm/specConfig.h

#ifndef SPEC_CONFIG_H_INCLUDED
#define SPEC_CONFIG_H_INCLUDED

#include "system.h"
#include "settings.h"

#define ADVANCED_BETADISK 1

enum SpecRom_Type { SpecRom_Classic48, SpecRom_Pentagon128, SpecRom_Pentagon1024 ,SpecRom_Scorpion};
enum SpecTurbo_Type { SpecTurbo_None, SpecTurbo_x2, SpecTurbo_x4, SpecTurbo_None_x8 };
enum SpecJoy_Type { SpecJoy_Kempston, SpecJoy_Sinclair1, SpecJoy_Sinclair2, SpecJoy_Cursor, SpecJoy_Qaopm };

struct CDiskImage
{
	char name[ PATH_SIZE ];
	int readOnly;
};

struct CSpecConfig
{
    char fpgaConfigName[ 16 ];

	int specRom;
	int specUseBank0;
	int specSync;
	int specTurbo;
	int specVideoMode;
	int specVideoAspectRatio;
	int specDacMode;
	int specAyMode;
	int specTurboSound;
	int specCovox;
	int specAyYm;
	int specBdiMode;
	int specJoyModeEmulation;
	int specJoyMode1;
	int specJoyMode2;
	int specMouseSensitivity;
	int specMouseSwap;
    int specFont;

	CDiskImage specImages[4];

	char snaName[ PATH_SIZE ];
};

extern CSpecConfig specConfig;
//extern CParameter iniParameters[];

const CParameter *GetIniParameters();
#define iniParameters GetIniParameters()

void RestreConfig();
void SaveConfig();

#endif
