z00m128/speccy2010/(commit log)

2010-07-05 Изменение в распайке кабеля VGA-SCART, для совместимости с платой VGA&PAL 1. RED 2. GREEN 3. BLUE 13. разрешение RGB на SCART 14. синхросмесь VIDEO
2010-07-06 Добавлена эмуляция kempston mouse.
    [Speccy2010_r1.bom.ods]
2010-07-06 Добавлена поддержка джойситков от SEGA.
2010-07-15 Merge branch 'local'
    Conflicts:
    trunk/firmware/arm/main.cpp
    trunk/firmware/fpga/src/speccy2010.vhd
2010-07-22 Улучшена работа с мышкой.
2010-07-29 Разукрашены имена файлов в шеле.
2010-07-29 Испавления в эмуляторе бетадиска и T80.
2010-09-10 Добавлен видео режим VGA 50 Hz - включается - Cntr + 3 Добавлена загрузка в турбо режимах Быстрое включение турбо режимов - Cntr + q, w, e, r Простая эмуляция порта 0xff.
2010-09-10 Обновленный ФАК
2010-09-13 Добавлен параметр в настройках - Aspect ratio; Исправлен немного AY, не шумит после ресета; Turbo включается клавишами F1-F4; Hex editor by skyther - вход ESC; При наличии в roms system.rom, грузится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
    [main.cpp, specConfig.cpp, specConfig.h, specShell.cpp, speccy2010.vhd]
2010-09-17 Изменение положения КСИ в VGA режиме для разных значений параметра Aspect ratio.
2010-10-11 Правильная эмуляция фирменного ZX Spectrum. Эмуляция RTC по схеме GLUK (только чтение). VGA режимы с частотой 60 и 75 Гц теперь выводет по 800 строк
2010-10-28 Исправлена ошибка, которая могла приводить к сбоям при работе с SDRAM.
    [main.cpp, specChars.h, specShell.cpp, speccy2010.vhd, system.h]
2010-10-28 Исправлен глюк с длинными именами.
2010-11-15 Добавлен бутлоадер. Теперь обе прошивки обновляются посредством записи их на карточку, но нужно сначала прошить бутлоадер.Подробности в новом факе. Добавлены времянки скорпиона. Сильно переписан код 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
2010-11-17 Улучшена работа BDI.
2010-11-20 Увеличена скорость роботы дискового интерфейса в несколько раз. Исправлены мелкие ошибки BDI (теперь идут unreal, refresh). Ресет продублирован на SCROLL LOCK.
    [main.cpp, specShell.cpp, speccy2010.vhd, system.h]
2010-11-22 Исправлены мелкие ошибки BDI (теперь запускается isdos). Ресет перенесен на print screen.
    [system.h]
2010-11-25 Исправлены мелкие ошибки BDI (insult, ROBO1024, BV_219). Подправлен порт клавиатуры - выдает 0xBF если клавиши не нажаты.
    [speccy2010.vhd, system.h]
2010-12-06 F9 - общие настройки F10 - меню с примонтироваными дисками Проверка наличия часов Увеличено максимальное количество файлов в папке до 9999, если больше - сообщение об ошибке BACKSPACE в шеле - выход 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
    [main.cpp, specConfig.cpp, specConfig.h, specShell.cpp, speccy2010.vhd, system.h]
2010-12-22 Запись снапшотов с фиксированными именами (по Alt + цифра[0..9]) - (добавил RabidRabbit) Отображение размера выбранного файла в шелле - (добавил RabidRabbit) Удаление файлов по F8 в шелле Новый шрифт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
2011-01-24 Расширены возможности проводника (копирование, перемещение файлов, создание, "форматирование" образа trd) Помощь по клавишам управления - F1 в проводнике Групповые операции в проводнике Отображение д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
2011-01-25 Добавлена возможность прервать копирование в проводнике кл ESC. Исправления в коде плис.
    [specShell.cpp, speccy2010.vhd]
2011-04-09 При выводе лога конец строки теперь передается как '\r\n' (совместимость с терминалками) (Чтобы бут тоже выводил '\r\n', нужно его обновить до версии 1.1) Добавлена инверсия кнопок на мышке (клавиша 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
    [main.c, main.cpp, specConfig.cpp, specConfig.h, specShell.cpp, speccy2010.vhd]
2011-09-19 Добавлена поддержка trd образов с длинной, не кратной длине дорожки.
2011-10-12 Commited WIP sources for r51.4 Added Scorpion support, SounDrive, AY/YM switching, TurboSound See readme for details
2011-10-13 Turned on SID emulation Scorpion stability is...questionable for turbo>x2 Refactored mixer to improve clock delay issue Added dedicated 16bit mixer input
    [speccy2010.vhd]
2011-10-16 Fixed scorpion issues (AY and NMI)
    [speccy2010.vhd]
2011-10-19 Fixed scorpion issue (128 TRDOS)
    [speccy2010.vhd]
2011-10-19 Fixed scorpion issue (Mapping page 8 to 0x0000 - 0x3fff)
    [speccy2010.vhd]
2011-10-31 [main] Added Scorpion support, SounDrive, AY/YM switching, TurboSound (merged with poopisan branch)
2014-10-25 axc`s fix was applied
    [main.cpp, speccy2010.vhd]
2019-06-20 ARM build fix and makefile (by mborik).
    [system.h]
2019-06-20 Fixed CDP project, fixed FPGA temperature profile.
